BrandonGel/ME393-4/README.md

ME393-4 Senior Design Capstone Project from 2021 Fall - 2022 Spring

Goal: Design and create a water-powered cart that can transports the same water used for energizing the cart to another location for points

Competition: ASME Student Design Competition (SDC) H2Go

Code: Motor Speed Control # is the final iteration of the project, combining bluetooth, motor control, and alternator control into one folder.
