BrandonGel/ME393-4/App Image/Bluetooth.jpg

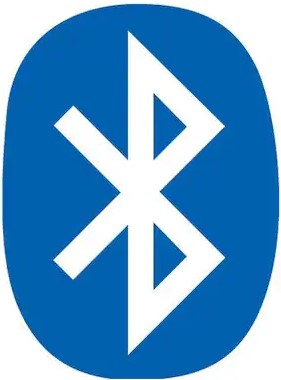
App Image/Bluetooth.jpg
