BrandonGel/ME393-4/Motor_Test/step_Gur.pdf

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

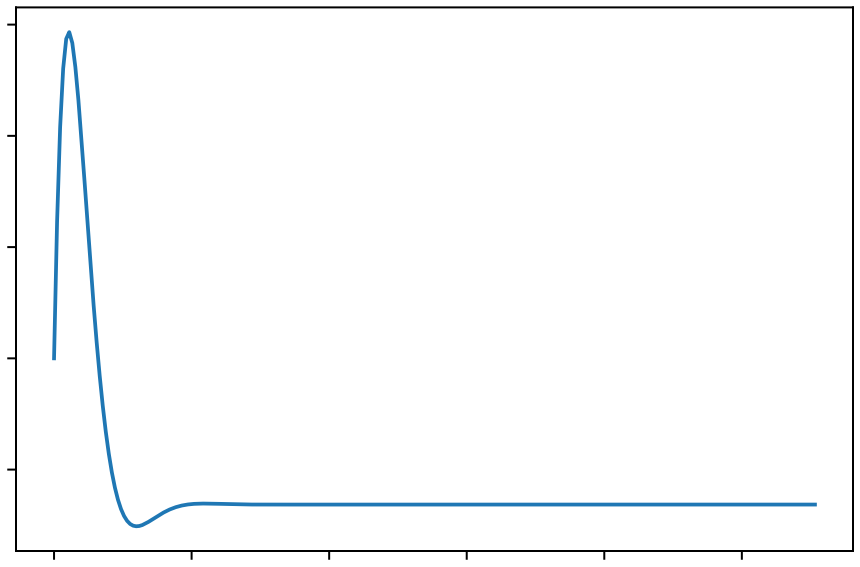
[picture p35: figure]
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
