BrandonGel/ME393-4/Motor_Test/HW5step.png

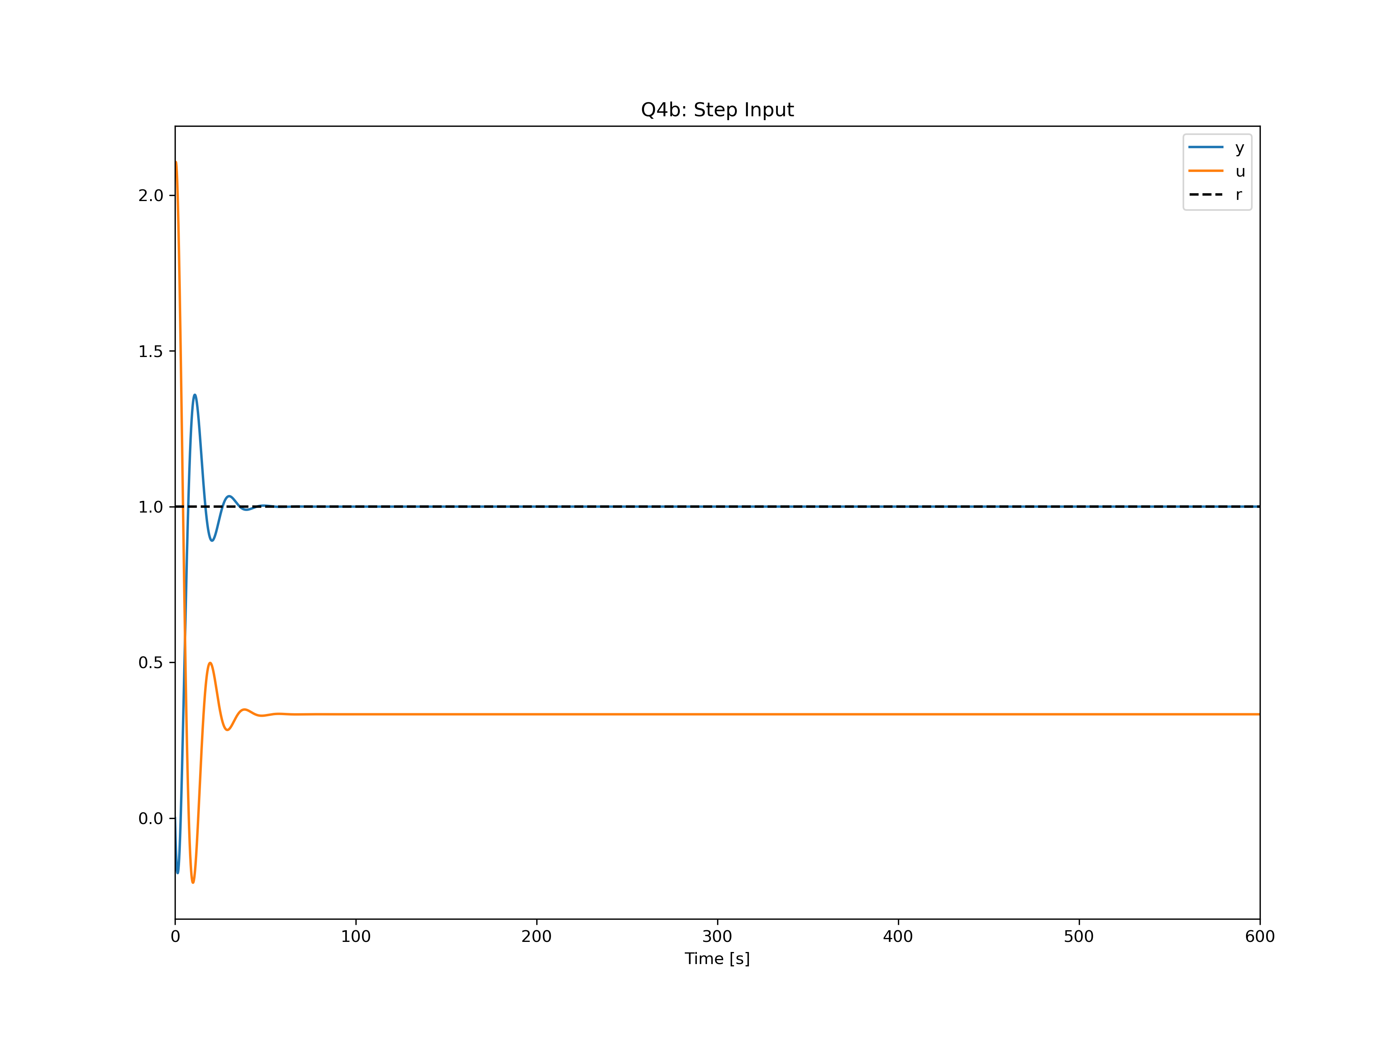
Motor_Test/HW5step.png
