BrandonGel/ME393-4/Motor_Test/Filter.py

# -*- coding: utf-8 -*-
"""
Created on Thu Dec 23 18:22:08 2021

@author: brand
"""

# Packages and adjustments to the figures
from scipy import signal
import matplotlib.pyplot as plt
import numpy as np
import math

# Close all figures
plt.close('all')



# In[]
# Generate a signal
samplingFreq = 200; # sampled at 1 kHz = 1000 samples / second
tlims = [0,1]        # in seconds
signalFreq = [2,50]; # Cycles / second
signalMag = [1,0.2]; # magnitude of each sine
t = np.linspace(tlims[0],tlims[1],(tlims[1]-tlims[0])*samplingFreq)
y = signalMag[0]*np.sin(2*math.pi*signalFreq[0]*t) + signalMag[1]*np.sin(2*math.pi*signalFreq[1]*t)

# Compute the Fourier transform
yhat = np.fft.fft(y);
fcycles = np.fft.fftfreq(len(t),d=1.0/samplingFreq); # the frequencies in cycles/s

# Plot the signal
plt.figure()
plt.plot(t,y);
plt.ylabel(r"$y(t)$");
plt.xlabel(r"$t$ (s)");
plt.xlim([min(t),max(t)]);

# Plot the power spectrum
plt.figure()
plt.plot(fcycles,np.absolute(yhat));
plt.xlim([-100,100]);
plt.xlabel(r"$\omega$ (1/s)");
plt.ylabel(r"$|\hat{y}|$");

# In[]
# Low-pass filter
w0 = 2*np.pi*25; # pole frequency (rad/s)
num = w0        # transfer function numerator coefficients
den = [1,w0]    # transfer function denominator coefficients
lowPass = signal.TransferFunction(num,den) # Transfer function

# Generate the bode plot
w = np.logspace( np.log10(min(signalFreq)*2*np.pi/10), np.log10(max(signalFreq)*2*np.pi*10), 500 )
w, mag, phase = signal.bode(lowPass,w)

# Magnitude plot
plt.figure()
plt.semilogx(w, mag)
for sf in signalFreq:
    plt.semilogx([sf*2*np.pi,sf*2*np.pi],[min(mag),max(mag)],'k:')
plt.ylabel("Magnitude ($dB$)")
plt.xlim([min(w),max(w)])
plt.ylim([min(mag),max(mag)])

# Phase plot
plt.figure()
plt.semilogx(w, phase)  # Bode phase plot
plt.ylabel("Phase ($^\circ$)")
plt.xlabel("$\omega$ (rad/s)")
plt.xlim([min(w),max(w)])
plt.show()

# In[]
dt = 1.0/samplingFreq;
discreteLowPass = lowPass.to_discrete(dt,method='gbt',alpha=0.5)
print(discreteLowPass)

# In[]
# The coefficients from the discrete form of the filter transfer function (but with a negative sign)
b = discreteLowPass.num;
a = -discreteLowPass.den;
print("Filter coefficients b_i: " + str(b))
print("Filter coefficients a_i: " + str(a[1:]))

# Filter the signal
yfilt = np.zeros(len(y));
for i in range(3,len(y)):
    yfilt[i] = a[1]*yfilt[i-1] + b[0]*y[i] + b[1]*y[i-1];
    
# Plot the signal
plt.figure()
plt.plot(t,y);
plt.plot(t,yfilt);
plt.ylabel("$y(t)$")
plt.xlim([min(t),max(t)]);

# Generate Fourier transform
yfilthat = np.fft.fft(yfilt)
fcycles = np.fft.fftfreq(len(t),d=1.0/samplingFreq)

plt.figure()
plt.plot(fcycles,np.absolute(yhat));
plt.plot(fcycles,np.absolute(yfilthat));
plt.xlim([-100,100]);
plt.xlabel("$\omega$ (cycles/s)");
plt.ylabel("$|\hat{y}|$");
